Makerspace-Amiens-2025-26/Puzzle-Bot-Groupe01/README.md

# 🤖 Puzzle Bot

> Un robot capable de résoudre automatiquement des puzzles physiques en manipulant les pièces à l'aide d'un système d'aspiration.

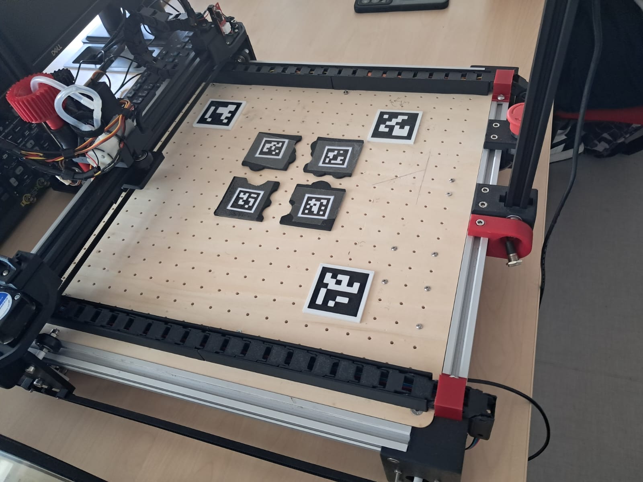
[picture p1: docs/images/machine.jpeg]


---

## 📖 Présentation

**Puzzle Bot** est un projet de robotique développé dans le cadre du **Makerspace Amiens 2025-2026**.

L'objectif est de concevoir un robot capable de résoudre automatiquement des puzzles physiques en identifiant, saisissant et déplaçant les pièces jusqu'à leur position correcte.

Pour réaliser cette tâche, le robot utilise un système de **ventouse** permettant d'aspirer les pièces puis de les déplacer avec précision sur la surface de travail.

Le projet combine plusieurs disciplines :

- Robotique
- Mécanique
- Électronique
- Informatique
---

## 📂 Structure du projet

```text
Puzzle-Bot/
│
├── docs/           # Documentation du projet
├── project/        # Code source
├── .github/        # Configuration GitHub
└── README.md
```

---

## 🛠️ Technologies utilisées

- Python
- Arduino / C++
- Systèmes embarqués
- Robotique
- Contrôle moteur
- Camera tracking / vision
- Kicad

---

## 🚀 État actuel du projet

Le robot est actuellement capable de :

- Manipuler des pièces de puzzle de tailles moyennes.
- Saisir les pièces grâce à un système de ventouse.
- Déplacer les pièces vers une position définie.
- Résoudre des puzzles simples.

Des améliorations sont encore en cours de développement afin d'augmenter la taille des puzzles pris en charge ainsi que la vitesse et la précision de résolution.

---

## 🔮 Perspectives d'évolution

- Support de puzzles de plus grande taille.
- Amélioration de la précision de placement.
- Optimisation des trajectoires de déplacement.
- Réduction du temps de résolution.
- Interface utilisateur pour le contrôle et le suivi des résolutions.

---

## 📚 Documentation

La documentation complète du projet est disponible sur le site GitHub Pages du projet :

https://makerspace-amiens-2025-26.github.io/Puzzle-Bot-Groupe01/

---

## 👥 Équipe

Projet réalisé par :

- Byron
- Nicolas
- Dorian
- Yvan
- Esteban
- Damien
- Aubin

---
N'hésitez pas à nous contacter pour toutes questions concernant le projet !
