Makerspace-Amiens-2025-26/Puzzle-Bot-Groupe01/docs/etapes/5_etapes.md

---
layout: default
title: Etapes de fabrication
nav_order: 4
has_children: true
---

# Étapes de Fabrication

Bienvenue dans la section dédiée aux étapes de fabrication de notre puzzle-bot. Ici, vous trouverez des guides détaillés pour chaque étape du processus de fabrication que voici ci-dessous.

## Aperçu des Étapes

Le processus de fabrication est divisé en plusieurs étapes clés :

1. [Matériaux et prototypage](etape_1)
2. [Conception et assemblage](etape_2)
3. [Electronique](etape_3)
4. [Numérique](etape_4)
5. [Calibration et amélioratioNS liées à la caméra](etape_4)
6. [Finitions](etape_6)
7. [Contrôle Qualité](etape_7)
