Makerspace-Amiens-2025-26/Puzzle-Bot-Groupe01/docs/Présentation Puzzle Bot 50H .pdf

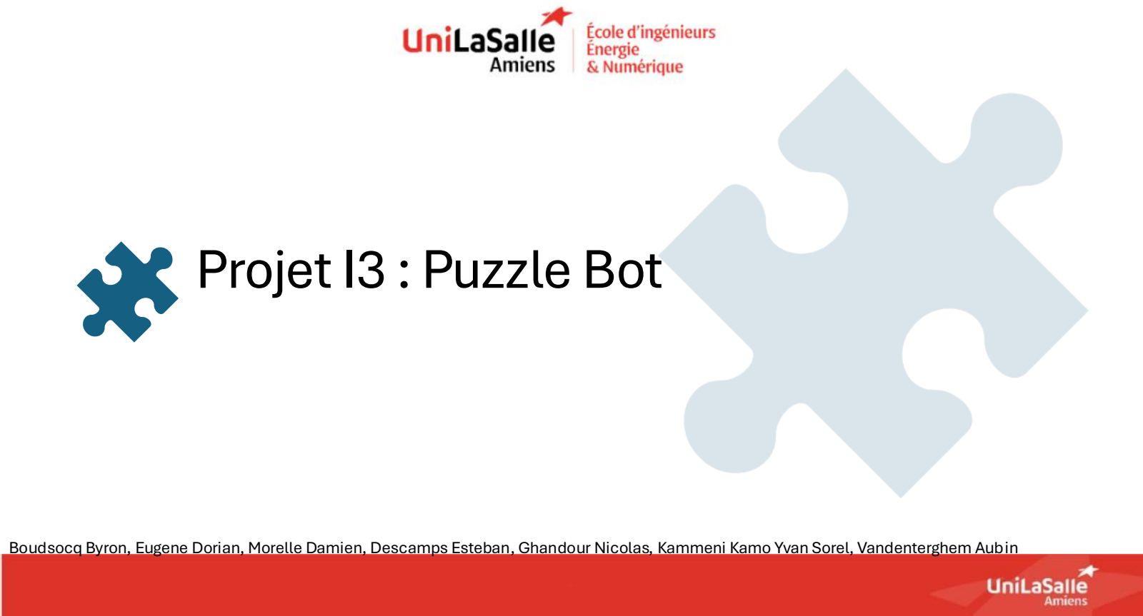
[picture p41: page 1]

# Projet I3 : Puzzle Bot

Boudsocq Byron, Eugene Dorian, Morelle Damien, Descamps Esteban, Ghandour Nicolas, Kammeni Kamo Yvan Sorel, Vandenterghem Aubin

# Introduction

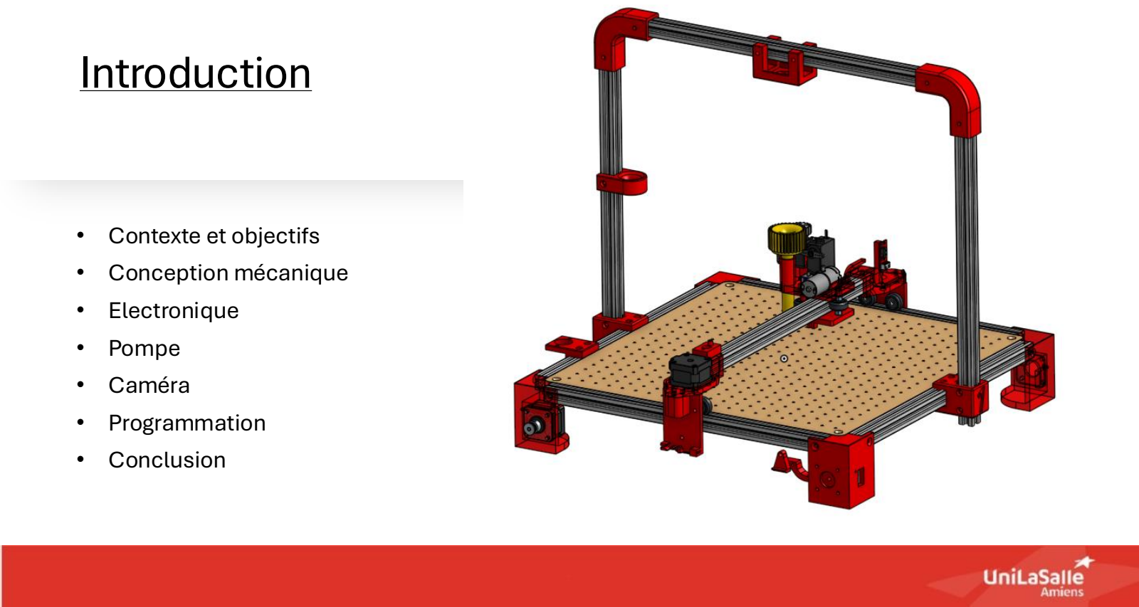
[picture p42: page 2]

- Contexte et objectifs
- Conception mécanique
- Electronique
- Pompe
- Caméra
- Programmation
- Conclusion

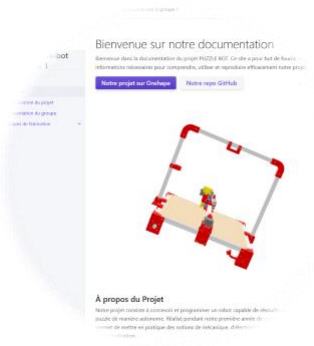
[picture p43: figure]

# Contexte et objectifs

- Projet de cours
- Inspirations
- "Proof of Concept" (POC)
- Github (contexte, objectifs, cahier des charges)

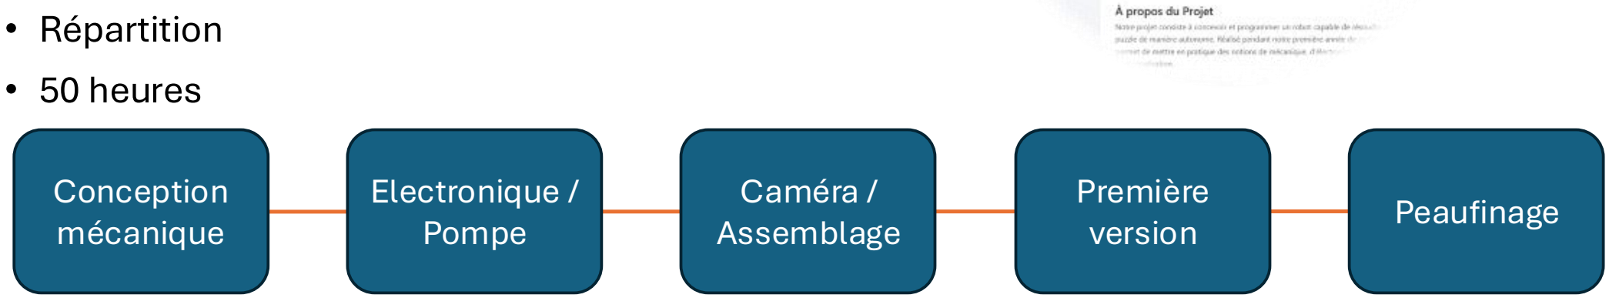
[picture p44: figure]
• Répartition • 50 heures; Conception mécanique; Electronique / Pompe; Caméra / Assemblage; Première; version; Peaufinage
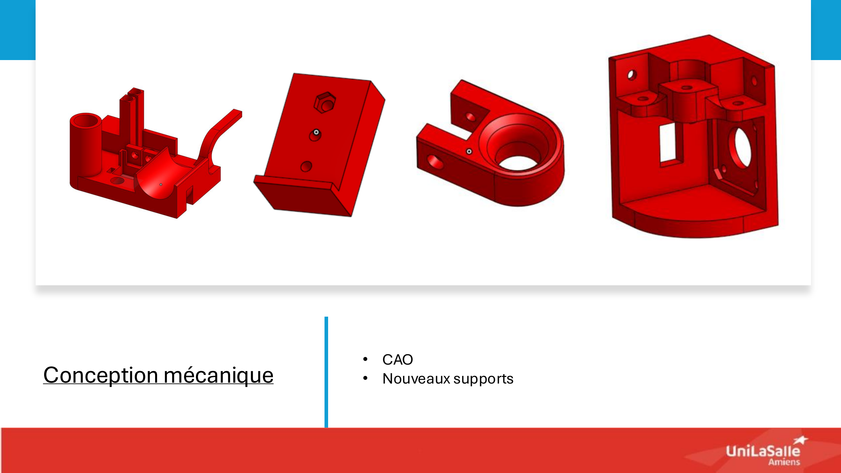
[picture p45: page 4]

## Conception mécanique

- CAO
- Nouveaux supports

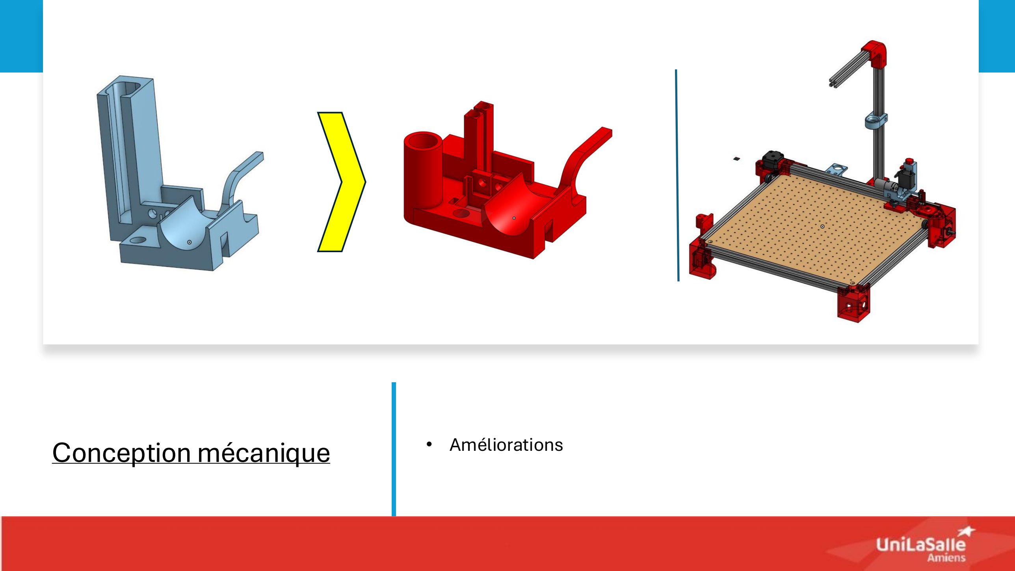
[picture p46: page 5]

## Conception mécanique • Améliorations

# Electronique

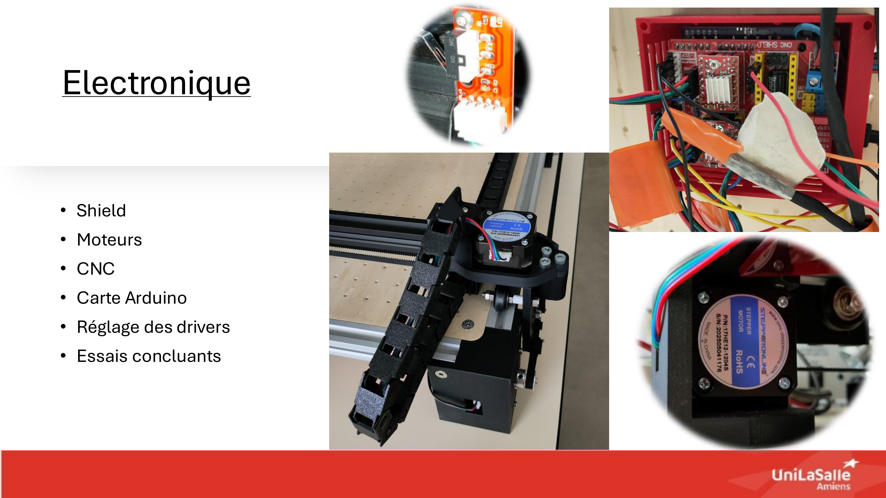
[picture p47: page 6]

- Shield
- Moteurs
- CNC
- Carte Arduino
- Réglage des drivers
- Essais concluants

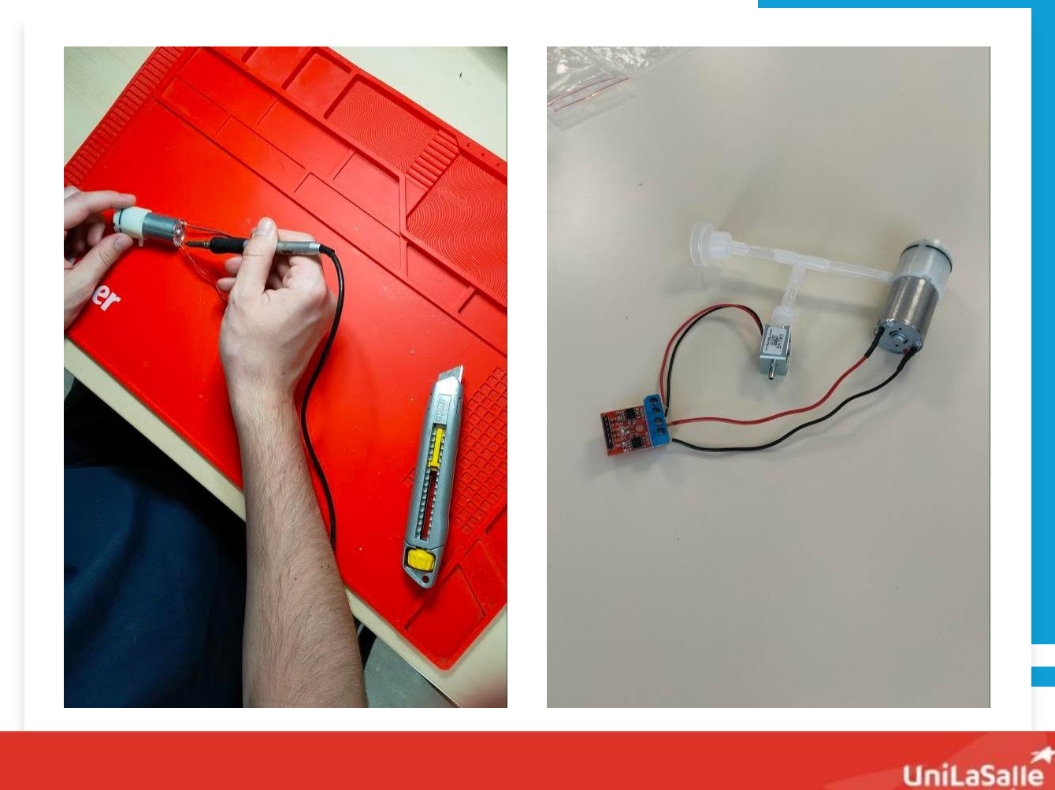
[picture p48: figure]

# Pompe

- Délais avant d'avoir la pompe \_ Etude des branchements
- Soudure des fils
- Test code
- Problème de voltage

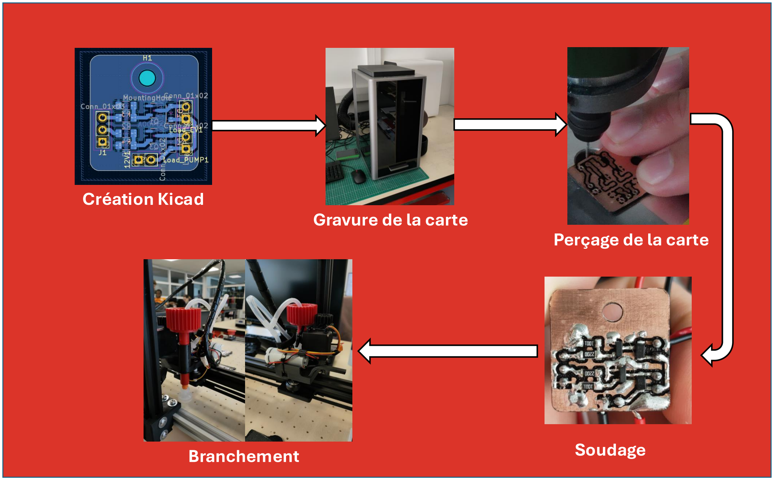
[picture p49: figure]
Soudage Branchement; Création Kicad; Gravure de la carte; Perçage de la carte

# Pompe

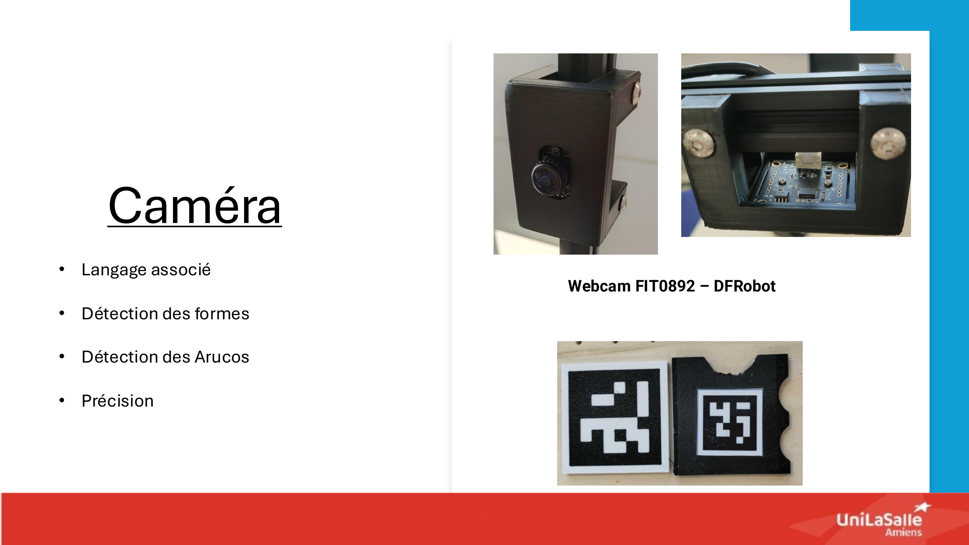
[picture p50: page 9]

# Caméra

- Langage associé
- Détection des formes
- Détection des Arucos
- Précision

Webcam FIT0892 – DFRobot

# Programmation

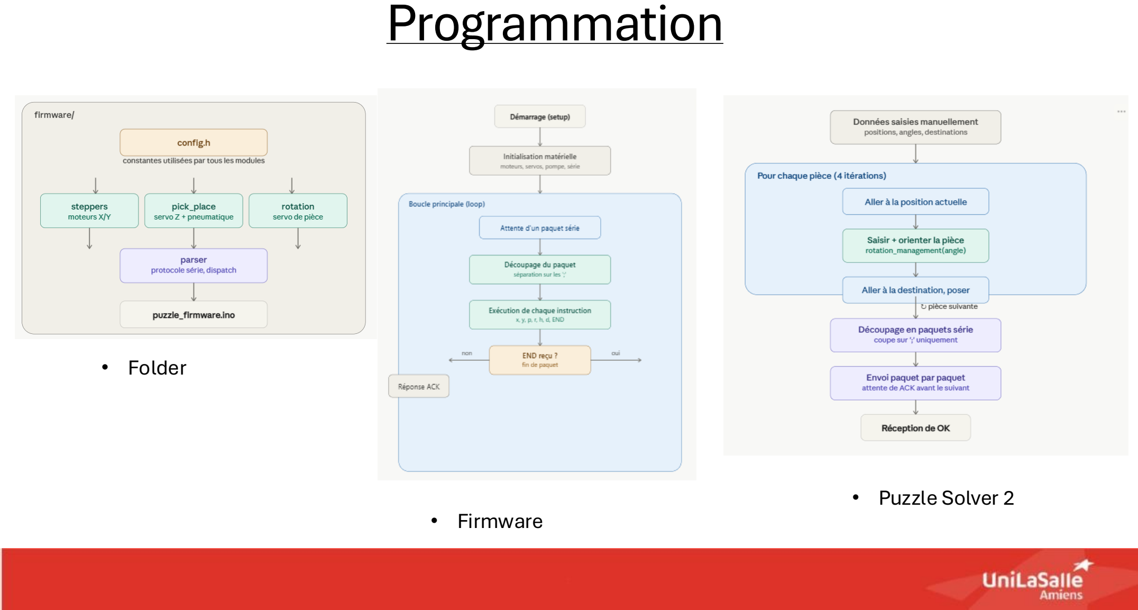
[picture p51: page 10]

Soudage Branchement • Firmware

- Puzzle Solver 2
- Folder

# Programmation

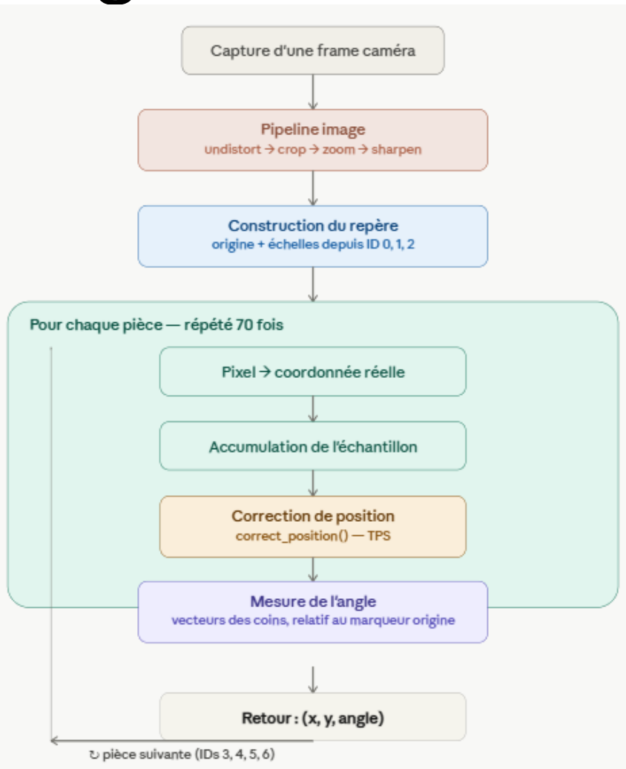
[picture p52: figure]
Branchement

- Détermination de la
position et de l'angle
de chaques pièces

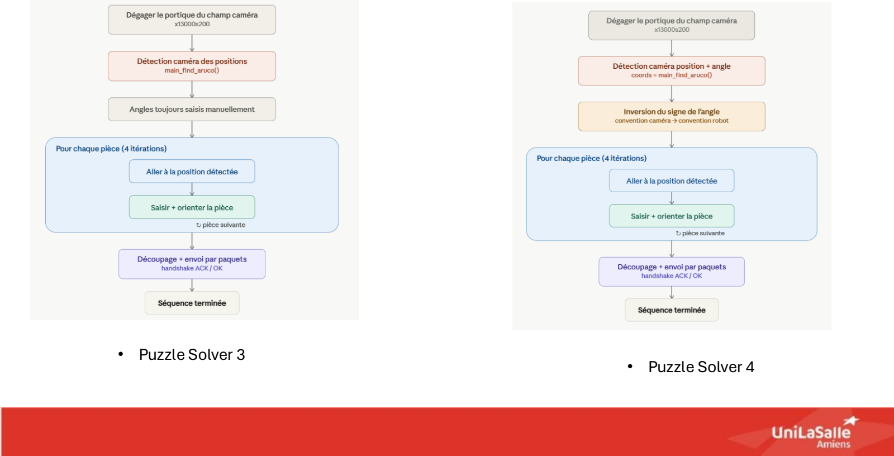
[picture p53: page 12]

# Programmation

Soudage

Branchement
- Puzzle Solver 3
- Puzzle Solver 4

# Programmation

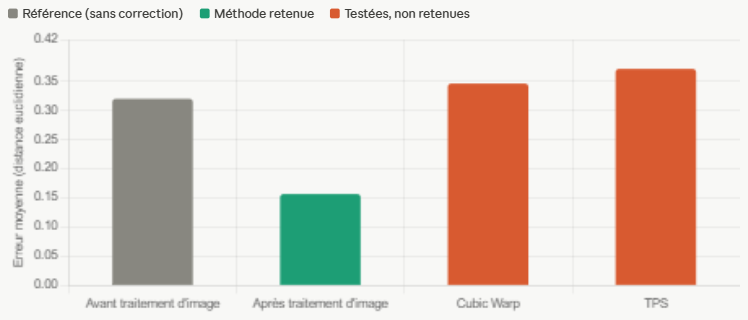
[picture p54: figure]

Branchement

- Algorithme de correction de position

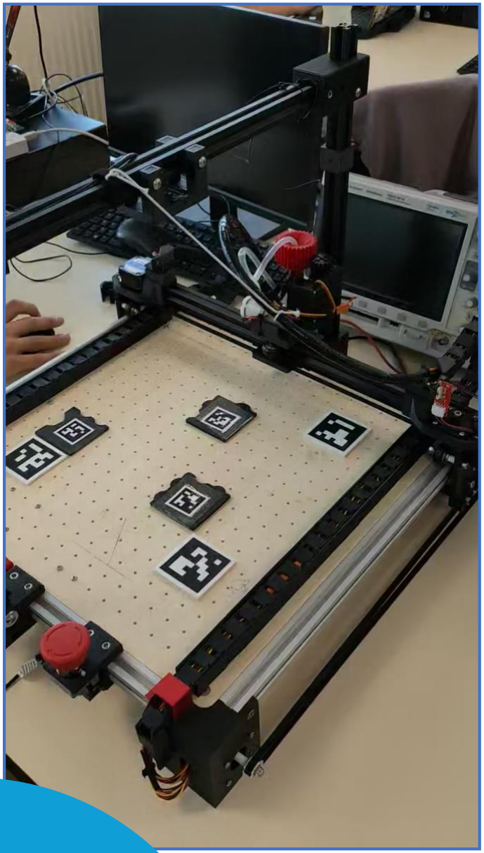
[picture p55: figure]

# Conclusion

- Structure mécanique fonctionnelle
- Intégration au domaine professionnel
- Possibles améliorations
