Makerspace-Amiens-2025-26/Puzzle-Bot-Groupe01/docs/1_Index.md

---
layout: home
nav_order: 1
title: Accueil
permalink: /
---

<script type="module" src="https://ajax.googleapis.com/ajax/libs/model-viewer/4.3.1/model-viewer.min.js"></script>

# Bienvenue sur notre documentation

Bienvenue dans la documentation du projet PUZZLE BOT. Ce site a pour but de fournir toutes les informations nécessaires pour comprendre, utiliser et reproduire efficacement notre projet.

[Notre projet sur Onshape](https://cad.onshape.com/documents/dc4e4dc410142a1f5ec17e75/w/6949f91d3f7293487ebace9c/e/d7efde2f999041b5a5ef0852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){: .btn .btn-primary .fs-5 .mb-4 .mb-md-0 .mr-2 }
[Notre repo GitHub](https://github.com/Makerspace-Amiens-2025-26/Puzzle-Bot-Groupe01){: .btn .fs-5 .mb-4 .mb-md-0 }

<model-viewer src="3D/PBF.gltf" style="width: 100%; height: 550px;" ar ar-modes="webxr scene-viewer quick-look" camera-controls tone-mapping="neutral" poster="poster.webp" shadow-intensity="1">
    <div class="progress-bar hide" slot="progress-bar">
        
    </div>
</model-viewer>

## À propos du Projet

Notre projet consiste à concevoir et programmer un robot capable de résoudre automatiquement un puzzle de manière autonome. Réalisé pendant notre première année de cycle ingénieur, ce projet nous permet de mettre en pratique des notions de mécanique, d’électronique, d’informatique et d’automatisation.

Le robot est destiné principalement à un usage pédagogique et expérimental. Il permet de découvrir le fonctionnement des systèmes embarqués, de la programmation d’algorithmes de résolution et de la coordination entre capteurs, moteurs et traitement des données.

Ce projet cherche à résoudre plusieurs problématiques techniques : analyser l’état d’un puzzle, déterminer une stratégie de résolution puis exécuter les mouvements nécessaires de manière précise et autonome. Hormis le côté technique, il vise également à développer notre capacité à travailler en équipe, à gérer un projet d’ingénierie et à réfléchir pour trouver une solution répondant à un défi concret.

## Poster

Ci-dessous, le poster que nous avons réalisé afin d'expliquer les principaux principes de fonctionnement de notre machine, les objectifs de notre projet, les logiciels utilisés ainsi qu'un QR code permettant d'accéder à ce répertoire github.

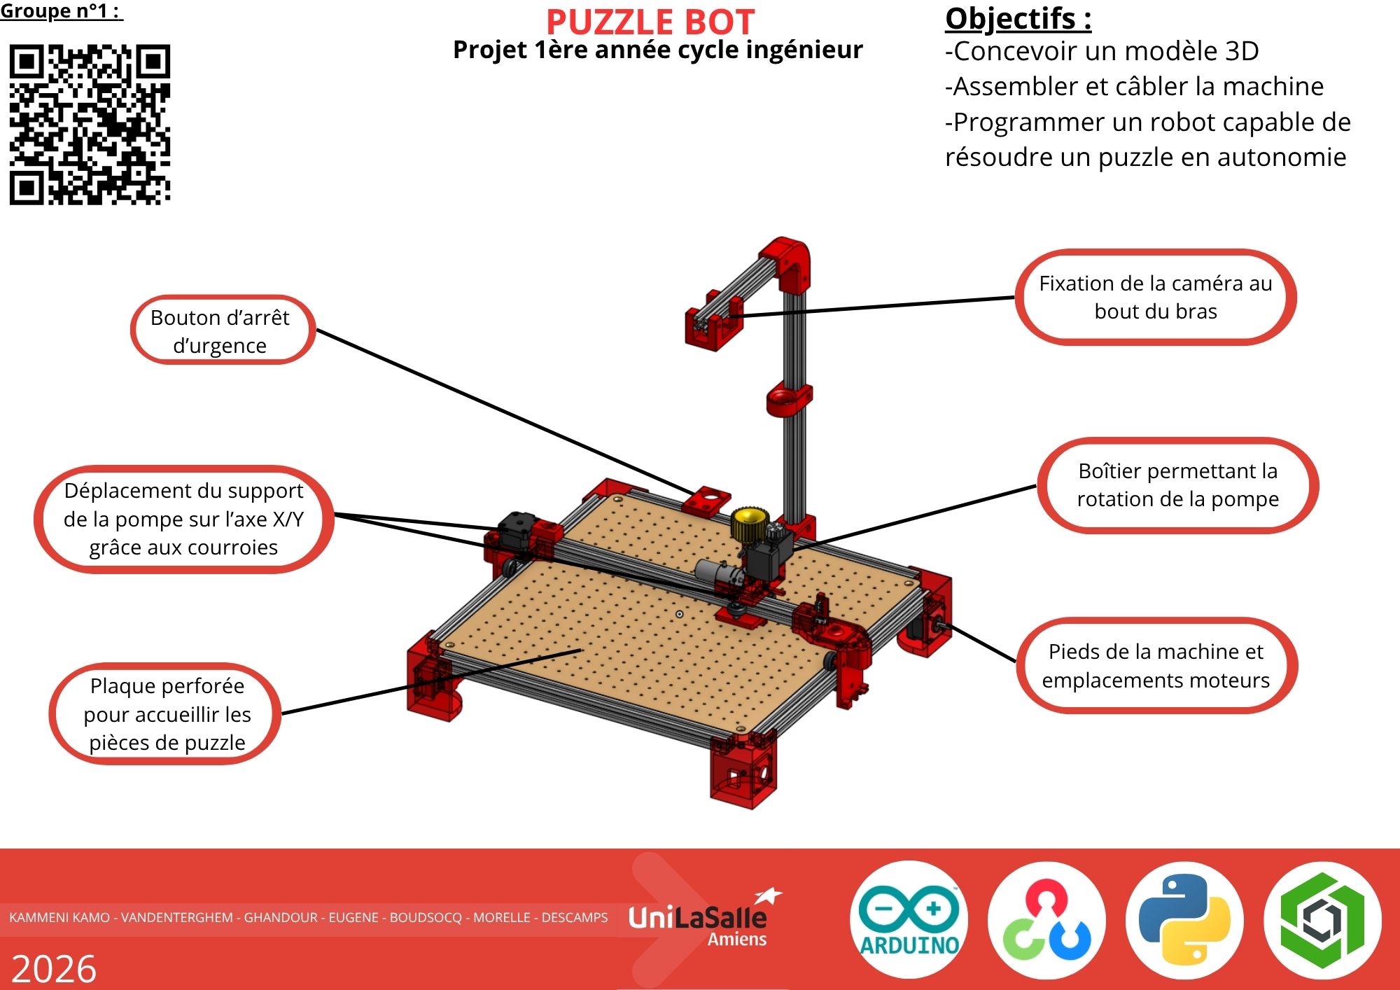
[picture p56: docs/images/poster.jpg]
Poster projet


## Vidéo

Ici, vous pouvez retrouver une courte [vidéo youtube](https://youtube.com/shorts/hwhFVxFwka4?is=Uxh004fbql3rNZwD) d'une minute et trente secondes retraçant les premiers pas de notre projet jusqu'à son résultat aujourd'hui.

Voici également un QR-code que vous pouvez scanner afin d'y accéder également.

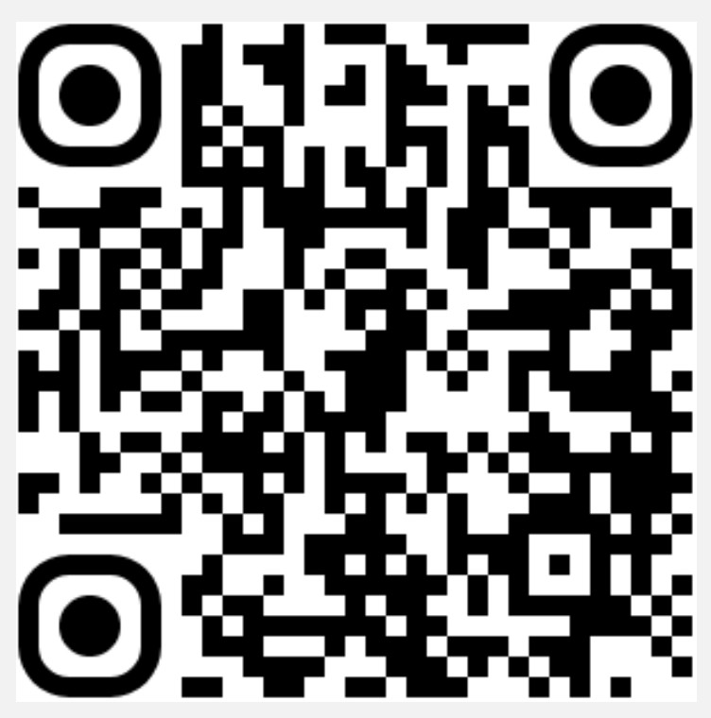
[picture p57: docs/images/qrcode_video.jpg]


---
