Makerspace-Amiens-2025-26/Puzzle-Bot-Groupe01/docs/etapes/etapes.md

---
layout: default
title: Etapes de fabrication
nav_order: 6
has_children: true
---

# Étapes de Fabrication

Bienvenue dans la section dédiée aux étapes de fabrication de notre puzzle-bot. Ici, vous trouverez des guides détaillés pour chaque étape du processus de fabrication que voici ci-dessous.

## Aperçu des Étapes

Le processus de fabrication est divisé en plusieurs étapes clés :

1. [Préparation des Matériaux](etape_2)
2. [Assemblage](etape_3)
3. [Finition](etape_4)
4. [Contrôle Qualité](etape_5)

## Commencer

Pour commencer, assurez-vous de bien comprendre chaque étape et de disposer de tous les outils et matériaux nécessaires. Suivez les étapes dans l'ordre pour garantir la qualité et l'efficacité du processus de fabrication.

---

Pour toute question ou aide supplémentaire, n'hésitez pas à contacter notre équipe.
