Makerspace-Amiens-2025-26/Puzzle-Bot-Groupe01/docs/images/mofset1.jpg

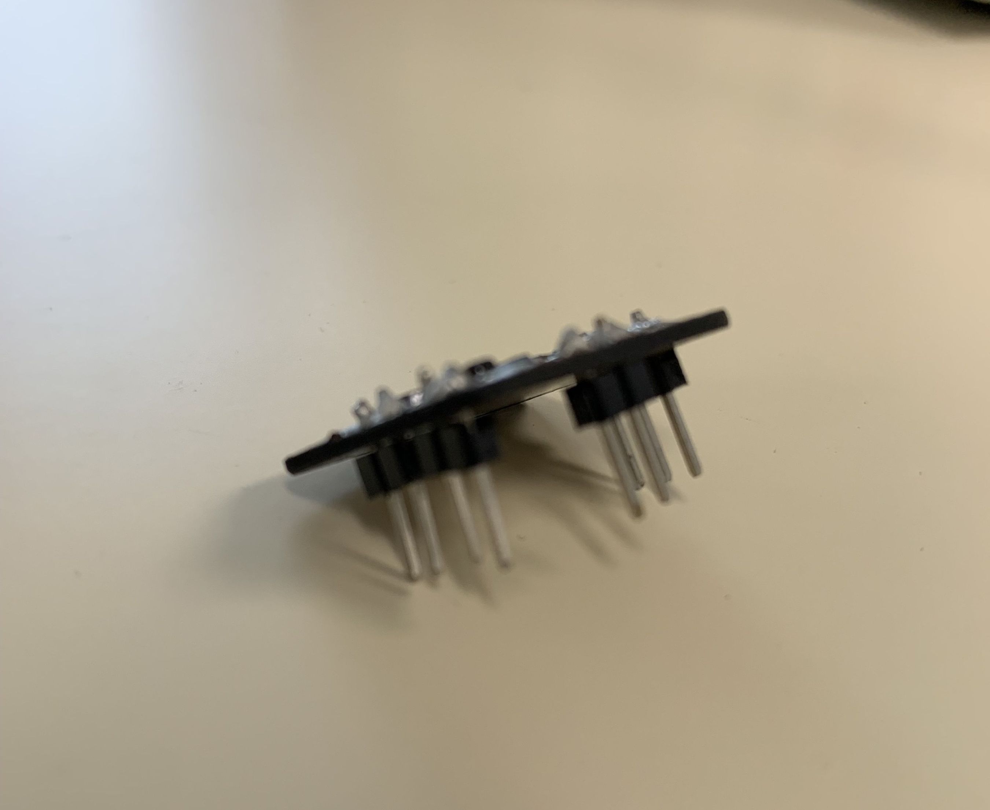
docs/images/mofset1.jpg
