Makerspace-Amiens-2025-26/Puzzle-Bot-Groupe01/project/Testings/READme

This folder contains testing files for each electronic component seperately.
