Makerspace-Amiens-2025-26/Puzzle-Bot-Groupe01/(commit log)

2026-05-21 Rename screen kikad PCB.PNG to screen KiCad PCB.PNG
2026-05-21 Rename screen kikad shéma.PNG to screen KiCad shéma.PNG
2026-06-12 Traduction steppers.cpp
2026-06-12 Traduction steppers.h
2026-06-13 Adding Coordinate system photo + some explanations in Calibration README.md
